seth-sievers/cc-led-driver/README.md

# cc-led-driver
A "cc" buck converter for dimming LED strips
