seth-sievers/cc-led-driver/docs/SystemDesignDocument.docx

CC LED Driver

System Design Document

Author: Seth Sievers

Created: 9/10/25

# Overview

# Table of Contents

# Hardware Design

## Requirements

- Flicker Free Dimming To Low Brightness -> DC output Buck
- Minimal emitted EMI -> Buck
- Potentiometer for Brightness Adjust with Gamma Correction

## Brightness Potentiometer (Gamma Correction)

The luminance (light energy) of an LED is roughly linear with the current through the LED. However, humans perceive luminance in a very nonlinear way, making the perceived brightness very nonlinear with output luminance. This is not ideal for manual adjustment as it is very difficult to get the brightness “just right”.

Perceived brightness roughly follows the following relation.

B=L^(1/γ) L=B^γ where γ≈2.2∈[1.5, 3]

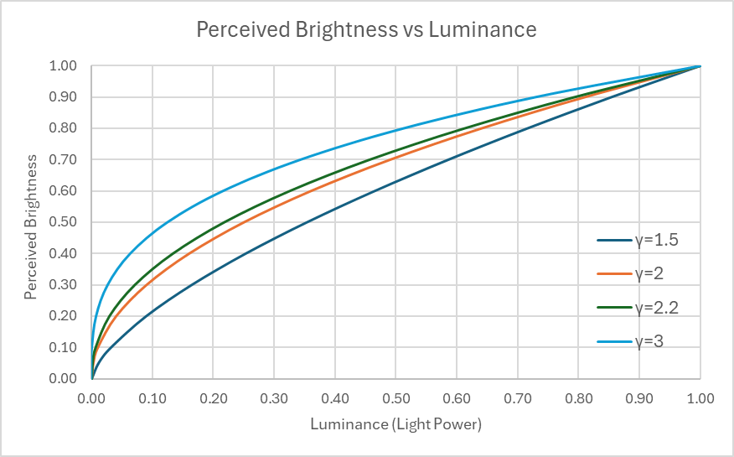
[picture p1: figure]

This is trivial to correct for in a microcontroller but since the LED driver will not have one a circuit that roughly follows the inverse of the above curve is needed. Flipping the X and Y axis to visualize the desired function:

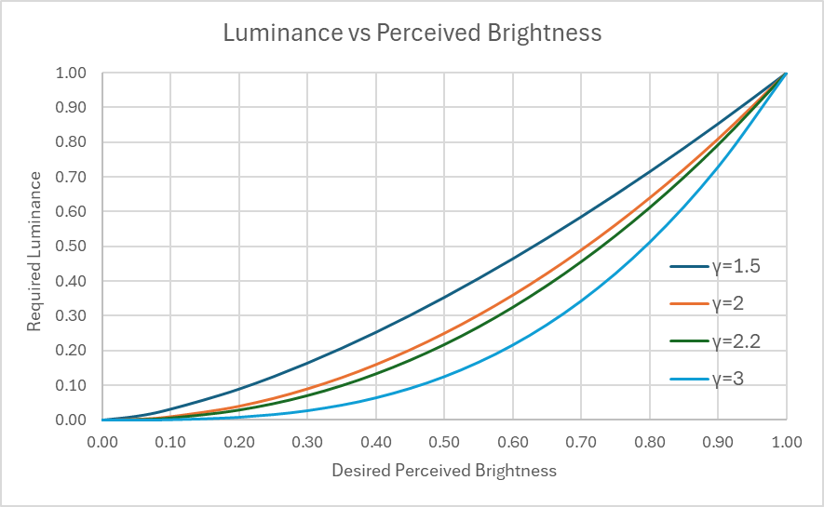
[picture p2: figure]

A rough mapping from a linear potentiometer to a curve fitting between the above family of curves would be ideal.

View Rough Circuit Sketch for a preliminary system overview.

After spending a very long time in LTspice, the following circuit was created.

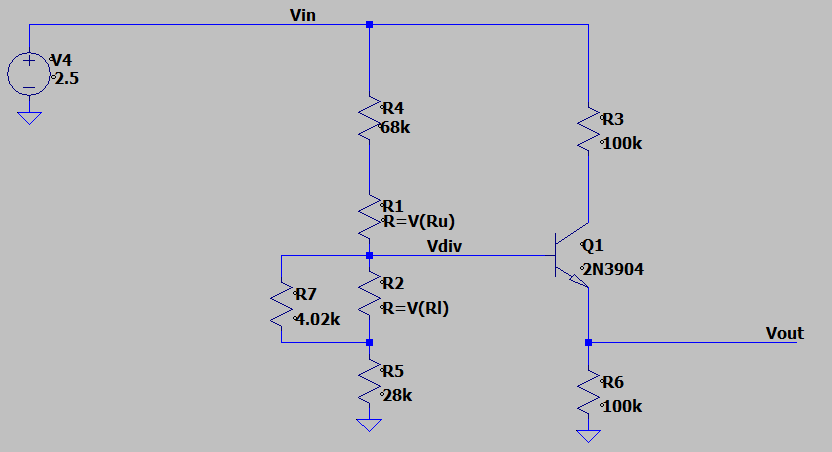
[picture p3: figure]

Which has the following response:

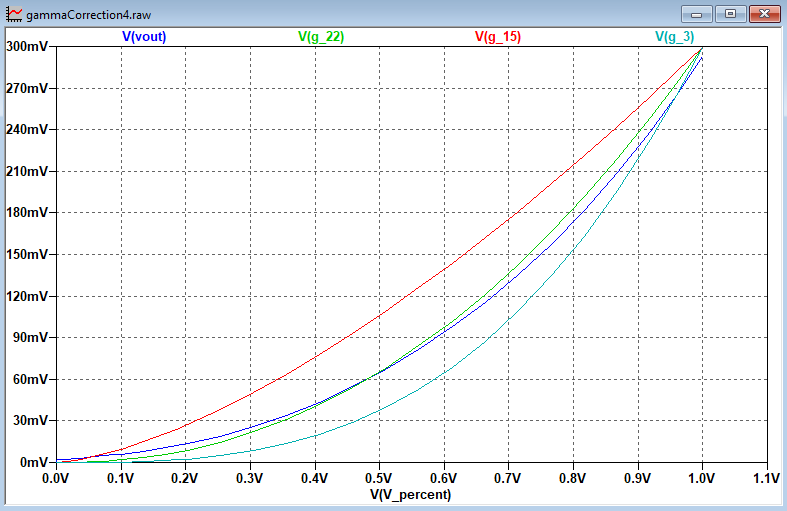
[picture p4: figure]

The above graph shows that the output almost perfectly follows the γ=2.2 curve and is well within the other boundary curves.

Next a simulation at 10C, 20C, and 30C was run to show how changes in the BJT’s VBE would impact the input output mapping.

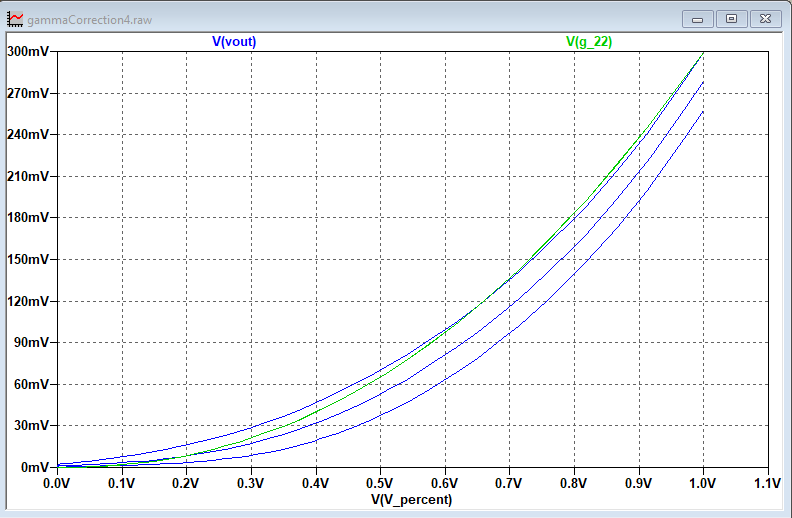
[picture p5: figure]

Luckily all curves stay mostly parallel with each other and the primary impact is small vertical offset of the mapping. This means variations in temperature will not change the relative impact in output brightness variation from turning the potentiometer but rather the overall max brightness. This BJT will be placed as far away as reasonably possible from the primary heat generating components and so large variations in temperature are not expected.

Checking the above graph shows that the minimum input percentage (V_percent) for which the resulting output voltage is above 12mV is 16%. The is the lowest setting of the potentiometer for which the led driver will turn on. Sixteen percent is adequate to ensure that noise does not cause the dimmer to flicker on and off. The highest percentage for which the output voltage is above 12mV is 34% A 16% delta for turning on the LEDs is not ideal but that is over a 20°C range which should not be encountered during a single usage. If this variance is an issue the curve or enable threshold can be adjusted.

## Buck Converter

The LED strip this dimmer is intended to power has a 12V @ 3A rating. This driver is intended to run from ~24V DC and act as a constant current source. The LMR33640 (https://www.digikey.com/en/products/detail/texas-instruments/LMR33640ADDAR/11308782) is a synchronous buck converter with a max input voltage of 36V and was chosen to the supply. It does not have a constant current mode so this will need to be implemented externally.

Using the current ripple equation from the datasheet to solve for the inductance required to achieve 30% ripple current with the maximum specified 4A output:

Yields an inductance of ~12.5µH. Solving for the minimum inductance required to avoid subharmonic oscillation:

Yields L ≥5.3μH as the lower bound.

Since lowering Vin reduces the inductance required for a % of ripple current and it is more likely that the driver will be used at input voltages lower than 24V rather than higher, the nearest lower standard inductor value of 10µH was chosen as a best guess.

The supply parameters were input into the SMPS spreadsheet to estimate inductor currents. The switching frequency is 400kHz. The efficiency was chosen to be a conservative 90% worst case.

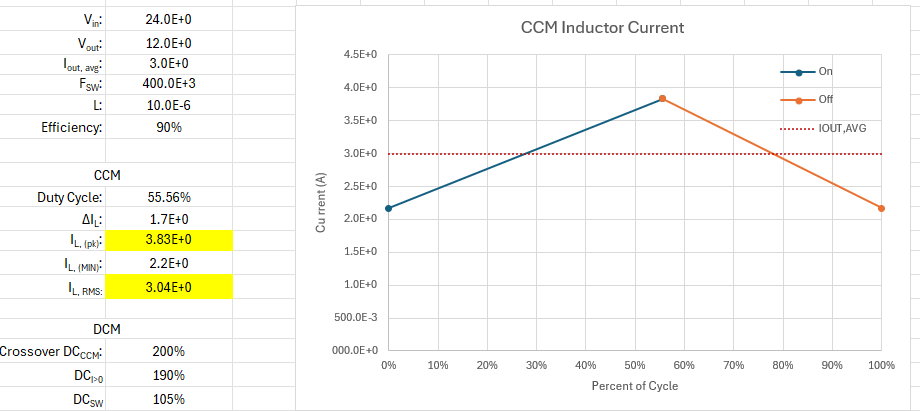
[picture p6: figure]

The spreadsheet predicts a peak inductor current of ~4A and an RMS inductor current of ~3A when providing 3A at 12V. From the converter datasheet, the high side switch current limit is typically 5.5A and the low side switch current limit is typically 4.5A so this is within the capability of the supply.

For an inductor, Vishay’s IHLP4040 (https://www.digikey.com/en/products/detail/vishay-dale/IHLP4040DZER100M11/1220709) series was chosen because it is relatively inexpensive, very capable, and has a preexisting footprint in KiCad (Inductor footprints are the worst).

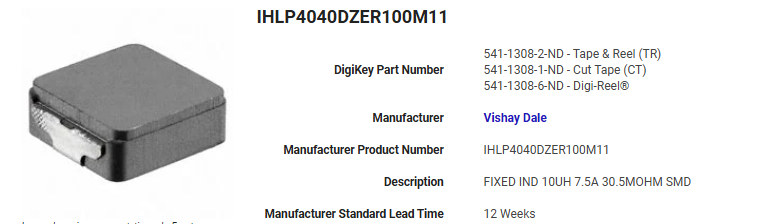
[picture p7: figure]

Specifications:

- IRMS = 7.5A
- ISAT = 7.1A
- DCR = 28mΩ

Since the IRMS and ISAT specifications for this inductor are both greater than the current limits for the switcher’s internal FETs, saturation for this inductor should be (almost) impossible, hopefully making this a very reliable supply. Furthermore, 28mΩ is a very low DC resistance and will only contribute to ~0.2% efficiency loss when the supply is providing 36W. Although AC losses will likely be higher than a ferrite core.

The current supply is as follows:

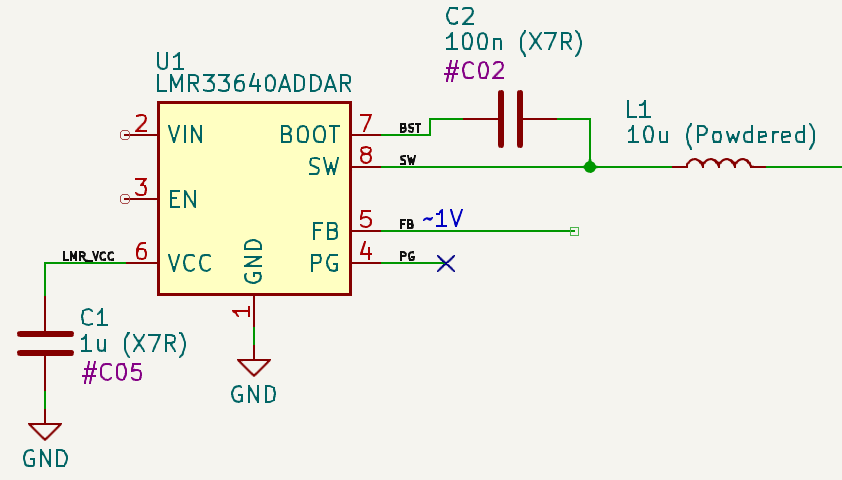
[picture p8: figure]

### Output Capacitance

Solving the output capacitance equation from the datasheet. Assume 30% inductor current ripple for a ballpark minimum. Set the voltage ripple to 100mV, Iout to 3A, and D to 56%. For worst case solve for a ∆IOUT of 3A.

Solving results in C_(OUT) ≥146µF , this is a somewhat extreme requirement as in normal steady state operation the change in current will be near zero as an LED strip does not exhibit high frequency switching.

Resolving the equation for ∆IOUT of 0.5A gives C_(OUT) ≥24µF

The datasheet also gives this table of typical values. Minimum Cout is listed as ~66 µF

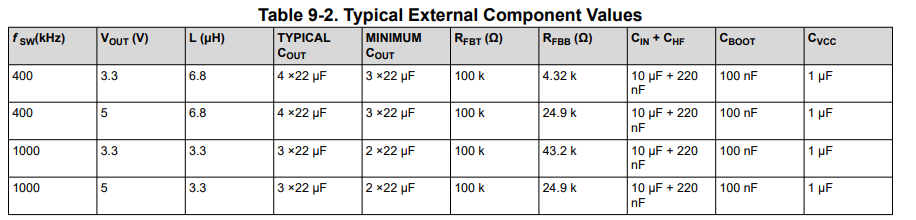
[picture p9: figure]

The datasheet does not give a formula for minimum COUT and the design example calculates 80µF. For this application, it was decided to use ten 10µF 50V X7R capacitors in a 1210 package. These capacitors have an effective capacitance of 7.1µF / ea when 13V is applied to them. The ten capacitor bank will have around 71µF of capacitance, more than the minimum specified 66 µF.

### Input Capacitance and EMI Filter

Luckily the input capacitance requirements are much less stringent. The datasheet calls for a minimum of 10 µF along with a small case size 220nF for HF bypassing. To achieve the 10µF the same 50V X7R caps as the output can be used. For the 220n cap several 100n 0603 50V caps can be used. However, I do not like putting different values of ceramic caps in parallel as it can cause resonance peaking from the high Q circuit that is formed. An LTspice sim of the input is necessary to determine if this is okay or if a damping resistance is necessary

For a buck converter, the input of the supply is also noisy since it is directly connected to a switching FET and does not have a filtering inductor like the output. Because a this a ferrite bead will be placed on the incoming ~24V supply to prevent noise conducting out and then radiating to the surrounding equipment.

The following input EMI filter was designed:

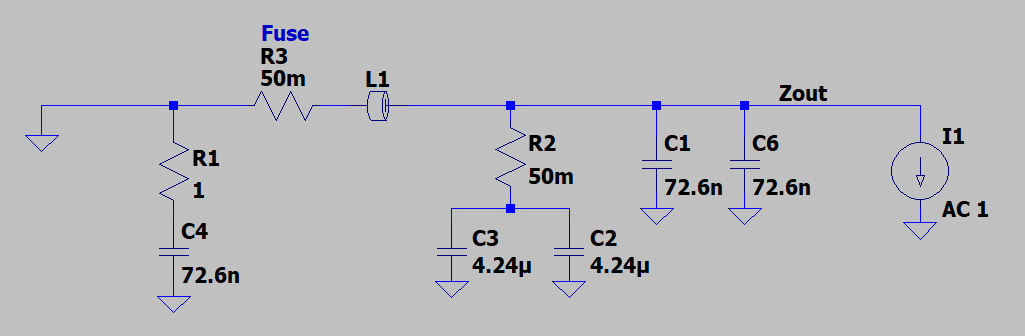
[picture p10: figure]

Resistances were strategically placed and chosen with the help of LTspice to damp out any resonances between the high Q ceramic capacitors. Since a fuse was desired, it was placed in the filter so that its resistance which would typically be undesirable is used to help damp the LC network.

The output impedance seen by the buck is as follows:

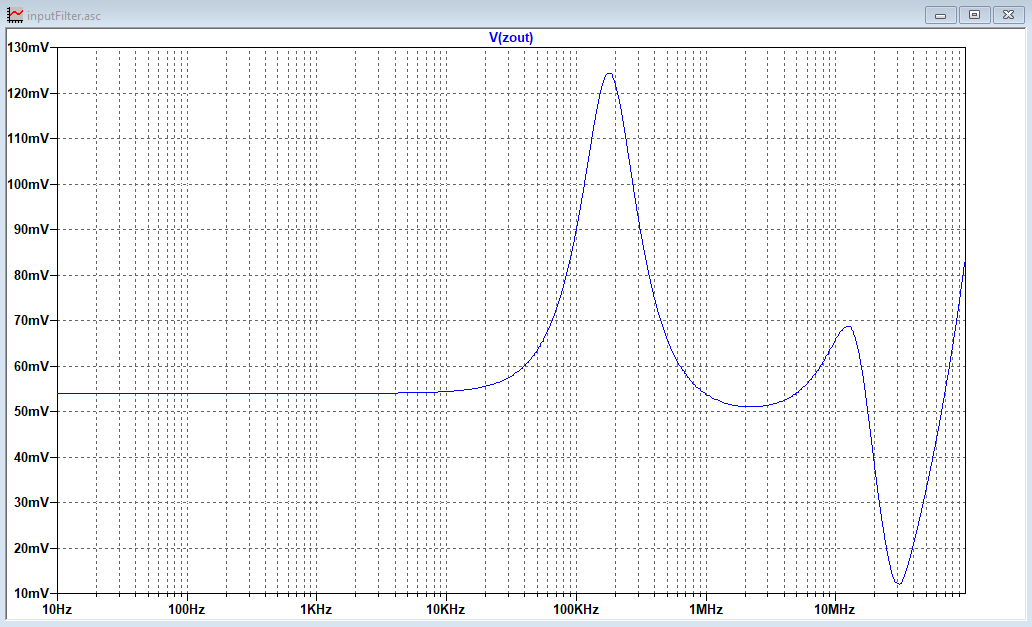
[picture p11: figure]

The Y axis of the above graph is Ohms. Note the large spike at ~175 kHz is not ideal. However, since that spike is only ~0.125Ω and since it can easily be adjusted by changing the damping resistor it will be left and tested. If the buck is still stable, this filter will provide superior damping.

The input impedance seen by the power supply source is as follows:

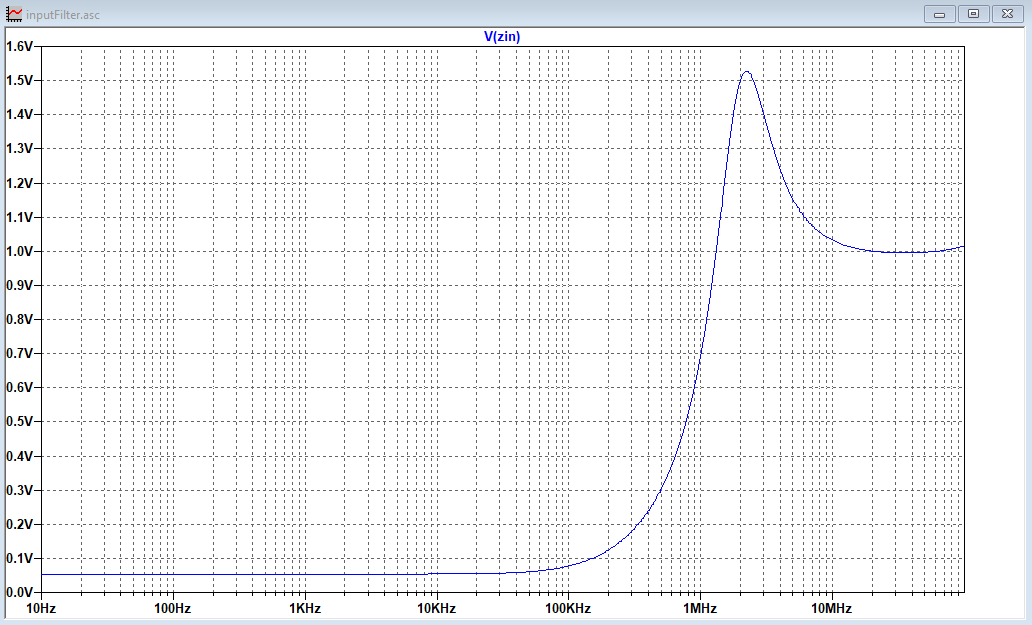
[picture p12: figure]

The above input impedance shows that the ferrite bead in combination with the ceramic capacitors cause a huge spike in input impedance that will attenuate high frequency current pulses from the supply.

And the overall frequency response from input -> output of the filter:

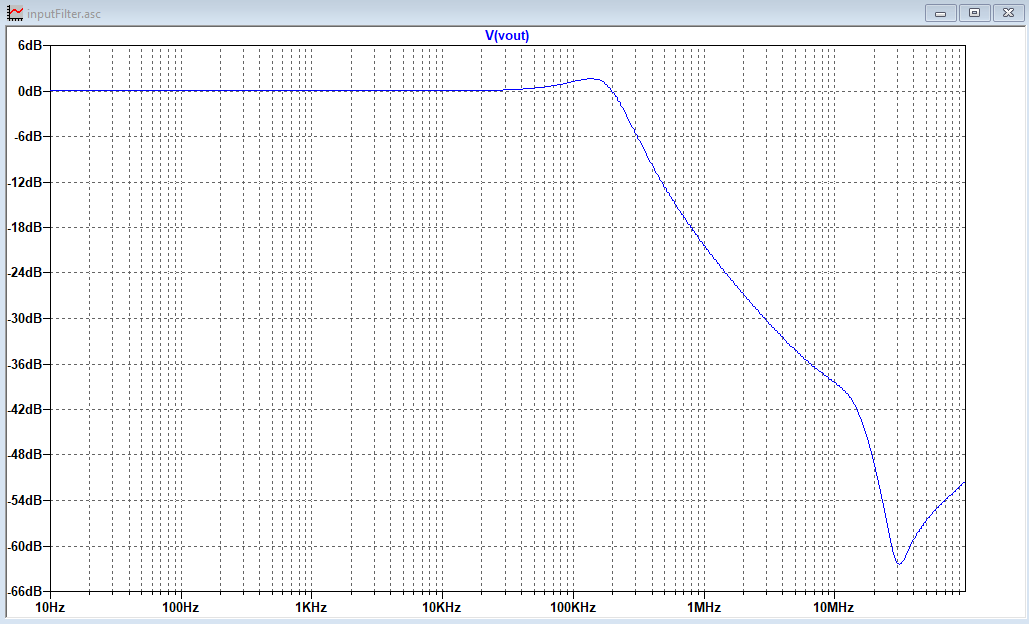
[picture p13: figure]

### CC Servo

Since the buck converter does not have a constant current mode, constant current operation will need to be implemented externally by driving the FB pin of the buck. This constant current control loop will have implications for the current set potentiometer, gamma correction circuit, and the buck feedback components. To make this solvable all these functional components must be chosen together. Start with an idea and try some values to see if it’s feasible.

One solution to regulate the buck output current is to simply use an opamp to drive the feedback pin of the buck until the current setpoint is achieved. However, since this buck has its compensation network fixed internally, this will likely prove difficult to stabilize since placing the current control loop inside the buck converters feedback will cause an additional phase shift. It is also desirable to have both a constant current control loop and a voltage control loop so that minimum and maximum output voltages can be set.

Solution:
Instead of driving the buck feedback pin directly, use the buck feedback resistor network to provide high frequency immediate feedback to the buck. The output voltage of the buck (which will directly influence the load current) will be set by a MUCH slower current feedback loop. This constant current “servo” will slowly steer or adjust the output voltage until the current drawn by the load is equal to the setpoint. Since an LED is not an active load with fast current transients this will achieve the desired constant current and correct for any temperature drift. Since the bandwidth of the current control loop will be extremely limited, it will have a minimal impact on the buck stability.

#### Rough Circuit Sketch:

#### Finalized Control Loop

The below finalized schematic snippet shows the slower current servo feedback loop. If VSET is greater than VSENSE, then the inverting integrator will slowly start increasing VCTRL. An increase in VCTRL will result in Q2 pulling the buck feedback voltage down. The much faster responding buck voltage control loop will then increase Vout which will result in a corresponding increase in LED current and thus an increase in VSENSE. VCTRL will continue to rise until VSENSE equals VSET at which point the integrator will maintain VCTRL and keep ‘steering’ the LED current back to the setpoint if it deviates.

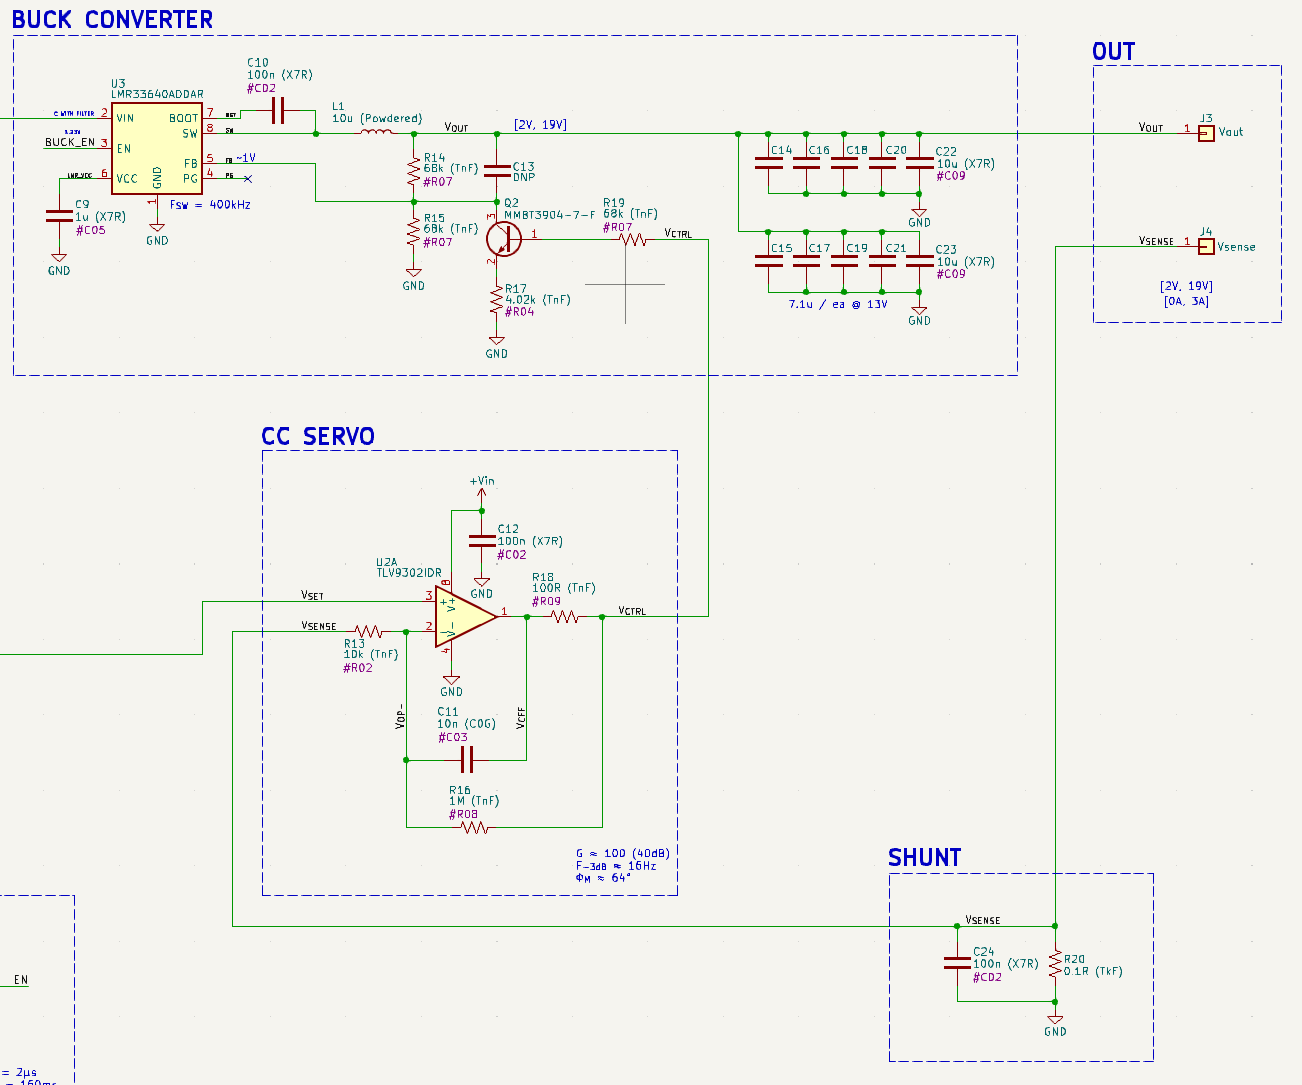
[picture p14: figure]
