seth-sievers/cc-led-driver/ltspice/Draft2.asc

C1: cap; 22.32µ; Rser=3m Lser=1.2n
C2: cap; 919n; Rser=10.9m Lser=372p
C3: cap; 919n; Rser=10.9m Lser=372p
C4: cap; 919n; Rser=10.9m Lser=372p
C5: cap; 919n; Rser=10.9m Lser=372p
C6: cap; 919n; Rser=10.9m Lser=372p
C7: cap; 919n; Rser=10.9m Lser=372p
C8: cap; 22.32µ; Rser=3m Lser=1.2n
I1: current; AC 1
L1: ind; 20n
L2: ind; 10n
R1: res; {Rdamp}
R2: res; 20m
R3: res; {Rdamp}
Named nets: 0, Z
.ac dec 1000 10 1G
.step param Rdamp list 1u 10m 20m 30m 40m 50m 100m 200m 1
