seth-sievers/cc-led-driver/ltspice/Draft3.asc

C1: cap; 20n
L1: ind; 100m
V1: voltage; PULSE(0 2.5 0 1n 1n 140.4u 280.99u)
Named nets: 0
.tran 0 1m 0 1u
