seth-sievers/cc-led-driver/ltspice/Draft1.asc

C1: cap; 94.55n; Rser=25.1m Lser=381p
C2: cap; 9.85µ; Rser=3m Lser=1.2n
I1: current; AC 1
R1: res; 100m
Named nets: 0, Z
.ac dec 1000 10 100Meg
