seth-sievers/cc-led-driver/ltspice/inputFilter.asc

C1: cap; 72.6n; Rser=25.1m Lser=381.7p
C2: cap; 4.24µ; Rser=2.9m Lser=1.1n
C3: cap; 4.24µ; Rser=2.9m Lser=1.1n
C4: cap; 72.6n; Rser=25.1m Lser=381.7p
C6: cap; 72.6n; Rser=25.1m Lser=381.7p
L1: FerriteBead; 88.4n; Rser=4m Rpar=37 Cpar=1.2p
R1: res; 1
R2: res; 50m
R3: res; 50m
V1: voltage; AC 1
Named nets: 0, Zin, Vout
.ac dec 1000 10 100Meg
Fuse
