seth-sievers/cc-led-driver/ltspice/buck_en.asc

C1: cap; 100n
D1: diode; 1N4148
D2: diode; 1N4148
R1: res; 200k
V1: voltage; PULSE(0 24 1m 1n 1n 100m 20); Rser=10
Named nets: 0, EN, BUCK_EN
.tran 0 0.3 0 1u
