seth-sievers/cc-led-driver/ltspice/cc_servo.asc

C1: cap; 10n
C2: cap; 100n
C3: cap; 20µ
D1: zener; UFZV9_1B
D2: zener; UFZV9_1B
D3: zener; UFZV9_1B
Q1: npn; 2N3904
R1: res; 100
R2: res; 200k
R3: res; 1k
R5: res; 0.1
R6: res; 850m
R7: res; 68k
R8: res; 68k
R9: res; 10m
R10: res; 4.02k
R11: res; 68k
U1: opamp2; TLV9302
U2: opamp
V1: voltage; 24
V2: voltage; 1; Rser=1
V3: voltage; 0
V4: voltage; PULSE(0 200m 100m 100m 100m 10 20)
Named nets: +24V, 0, -10V, Vctrl, Vsense, Vset, Vout, Vfb, Vb
.inc tlv9302.lib
.tran 0 1 0 100u
BUCK APPROXIMATION
"LED STRIP"
.lib opamp.sub
SHUNT
CC Servo
BW: ~10k
