seth-sievers/cc-led-driver/ltspice/en2.asc

B1: bv; V={Rpot}*(1-V(V_percent))
B2: bv; V={Rpot}*(V(V_percent))
B3: bv; V=pow({V(V_percent)}, 2.2)*{V(Vmax)}
B4: bv; V=pow({V(V_percent)}, 1.5)*{V(Vmax)}
B5: bv; V=pow({V(V_percent)}, 3)*{V(Vmax)}
C1: cap; 100n
C2: cap; 10n
C3: cap; 1n
C4: cap; 100n
C5: cap; 100n
C6: cap; 20µ
C7: cap; 120n
D1: diode; BAV199HY
D2: diode; BAV199HY
D3: zener; UFZV9_1B
D4: zener; UFZV9_1B
D5: zener; UFZV9_1B
Q1: npn; 2N3904
Q2: npn; 2N3904
R1: res; R=V(Ru)
R2: res; R=V(Rl)
R3: res; 100k
R4: res; 68k
R5: res; 28k
R6: res; 100k
R7: res; 4.02k
R8: res; 20k
R9: res; 100
R10: res; 1Meg
R11: res; 10k
R12: res; 200k
R13: res; 1k
R14: res; 200k
R15: res; 0.1
R16: res; 850m
R17: res; 68k
R18: res; 68k
R19: res; 10m
R20: res; 4.02k
R21: res; 68k
R22: res; 10k
R23: res; 1k
S1: sw; ENSW
S2: sw; ENSW_N
S3: sw; ENSW
U1: LM4040_NA2P5
U2: opamp2; TLV9302
U3: opamp2; TLV9302
U4: opamp
V1: voltage; PULSE(0 999m 10m 250m 250m 10 20)
V2: voltage; 300m
V3: voltage; 1n
V4: voltage; 1; Rser=1
V5: voltage; PULSE(0 24 1m 40n 40n 10 20); Rser=1m
V6: voltage; PULSE(2 0 11m 40n 40n 10 20)
Named nets: 0, V_percent, Ru, Rl, g_22, g_15, g_3, Vmax, Vset, Vdiv, Vin, VREF_2V5, Vctrl, VREF_12mV, EN, BUCK_EN, Vsense, Vout, Vfb, Vb, SS
.param Rpot=100k
.tran 0 1 0 100u
.inc LM4040_NA2P5_TRANS.lib
VREF
BRIGHTNESS CONTROL
.inc tlv9302.lib
.lib opamp.sub
CC Servo
SHUNT
BUCK APPROXIMATION
"LED STRIP"
BW: ~10k
.Model ENSW SW(Ron=1m Roff=1G Vt=1.231 Vh=1m)
.Model ENSW_N SW(Ron=1G Roff=1m Vt=1.231 Vh=1m)
