seth-sievers/cc-led-driver/ltspice/inverting_integrator_amp.asc

C1: cap; 10n
R1: res; 100
R2: res; 1Meg
R3: res; 10k
R4: res; 1k
U1: opamp2; TLV9302
V1: voltage; 24
V2: voltage; 0.15
V3: voltage; -10
V5: voltage; PULSE(0 0.3 1m 1n 1n 100m 200m)
Named nets: +24V, 0, -10V, Vout, Vin, Vset
.inc tlv9302.lib
.tran 0 1 0 100u
