seth-sievers/cc-led-driver/ltspice/inverting_integrator_amp_f_resp.asc

C1: cap; 10n
R1: res; 100
R2: res; 1Meg
R3: res; 10k
R4: res; 68k
U1: opamp2; TLV9302
V1: voltage; 20
V2: voltage; AC 1
V3: voltage; -20
Named nets: +24V, 0, -10V, Vout, Vin, Vset
.inc tlv9302.lib
;tran 0 1 0 100u
.ac dec 1000 1 100k
