seth-sievers/cc-led-driver/ltspice/gammaCorrection2.asc

B1: bv; V={Rpot}*(1-V(V_percent))
B2: bv; V={Rpot}*(V(V_percent))
B3: bv; V=pow({V(V_percent)}, 2.2)*{V(Vmax)}
B4: bv; V=pow({V(V_percent)}, 1.5)*{V(Vmax)}
B5: bv; V=pow({V(V_percent)}, 3)*{V(Vmax)}
Q1: npn; 2N3904
R1: res; R=V(Ru)
R2: res; R=V(Rl)
R3: res; 330k
R4: res; 330k
R5: res; 60.4k
R6: res; 330k
R7: res; 1Meg
V1: voltage; PULSE(0 1 0 1m 1m 10 20)
V2: voltage; 300m
V3: voltage; 1n
V4: voltage; 2.5
Named nets: 0, V_percent, Ru, Rl, Vin, g_22, g_15, g_3, Vmax, Vout
.param Rpot=100k
.tran 0 1m 0 100n
