seth-sievers/cc-led-driver/ltspice/gammaCorrection.asc

B1: bv; V={Rpot}*(1-V(V_percent))
B2: bv; V={Rpot}*(V(V_percent))
R1: res; R=V(Ru)
R2: res; R=V(Rl)
R3: res; 10k
V1: voltage; PULSE(0 1 0 1m 1m 10 20)
V2: voltage; 1
V3: voltage; 1n
Named nets: 0, V_percent, Ru, Rl, Vout, Vin
.param Rpot=100k
.tran 0 1m 0 100n
