seth-sievers/cc-led-driver/kicad/cc-led-driver.kicad_pcb

## KiCad design kicad/cc-led-driver.kicad_pcb (2025-10-31)

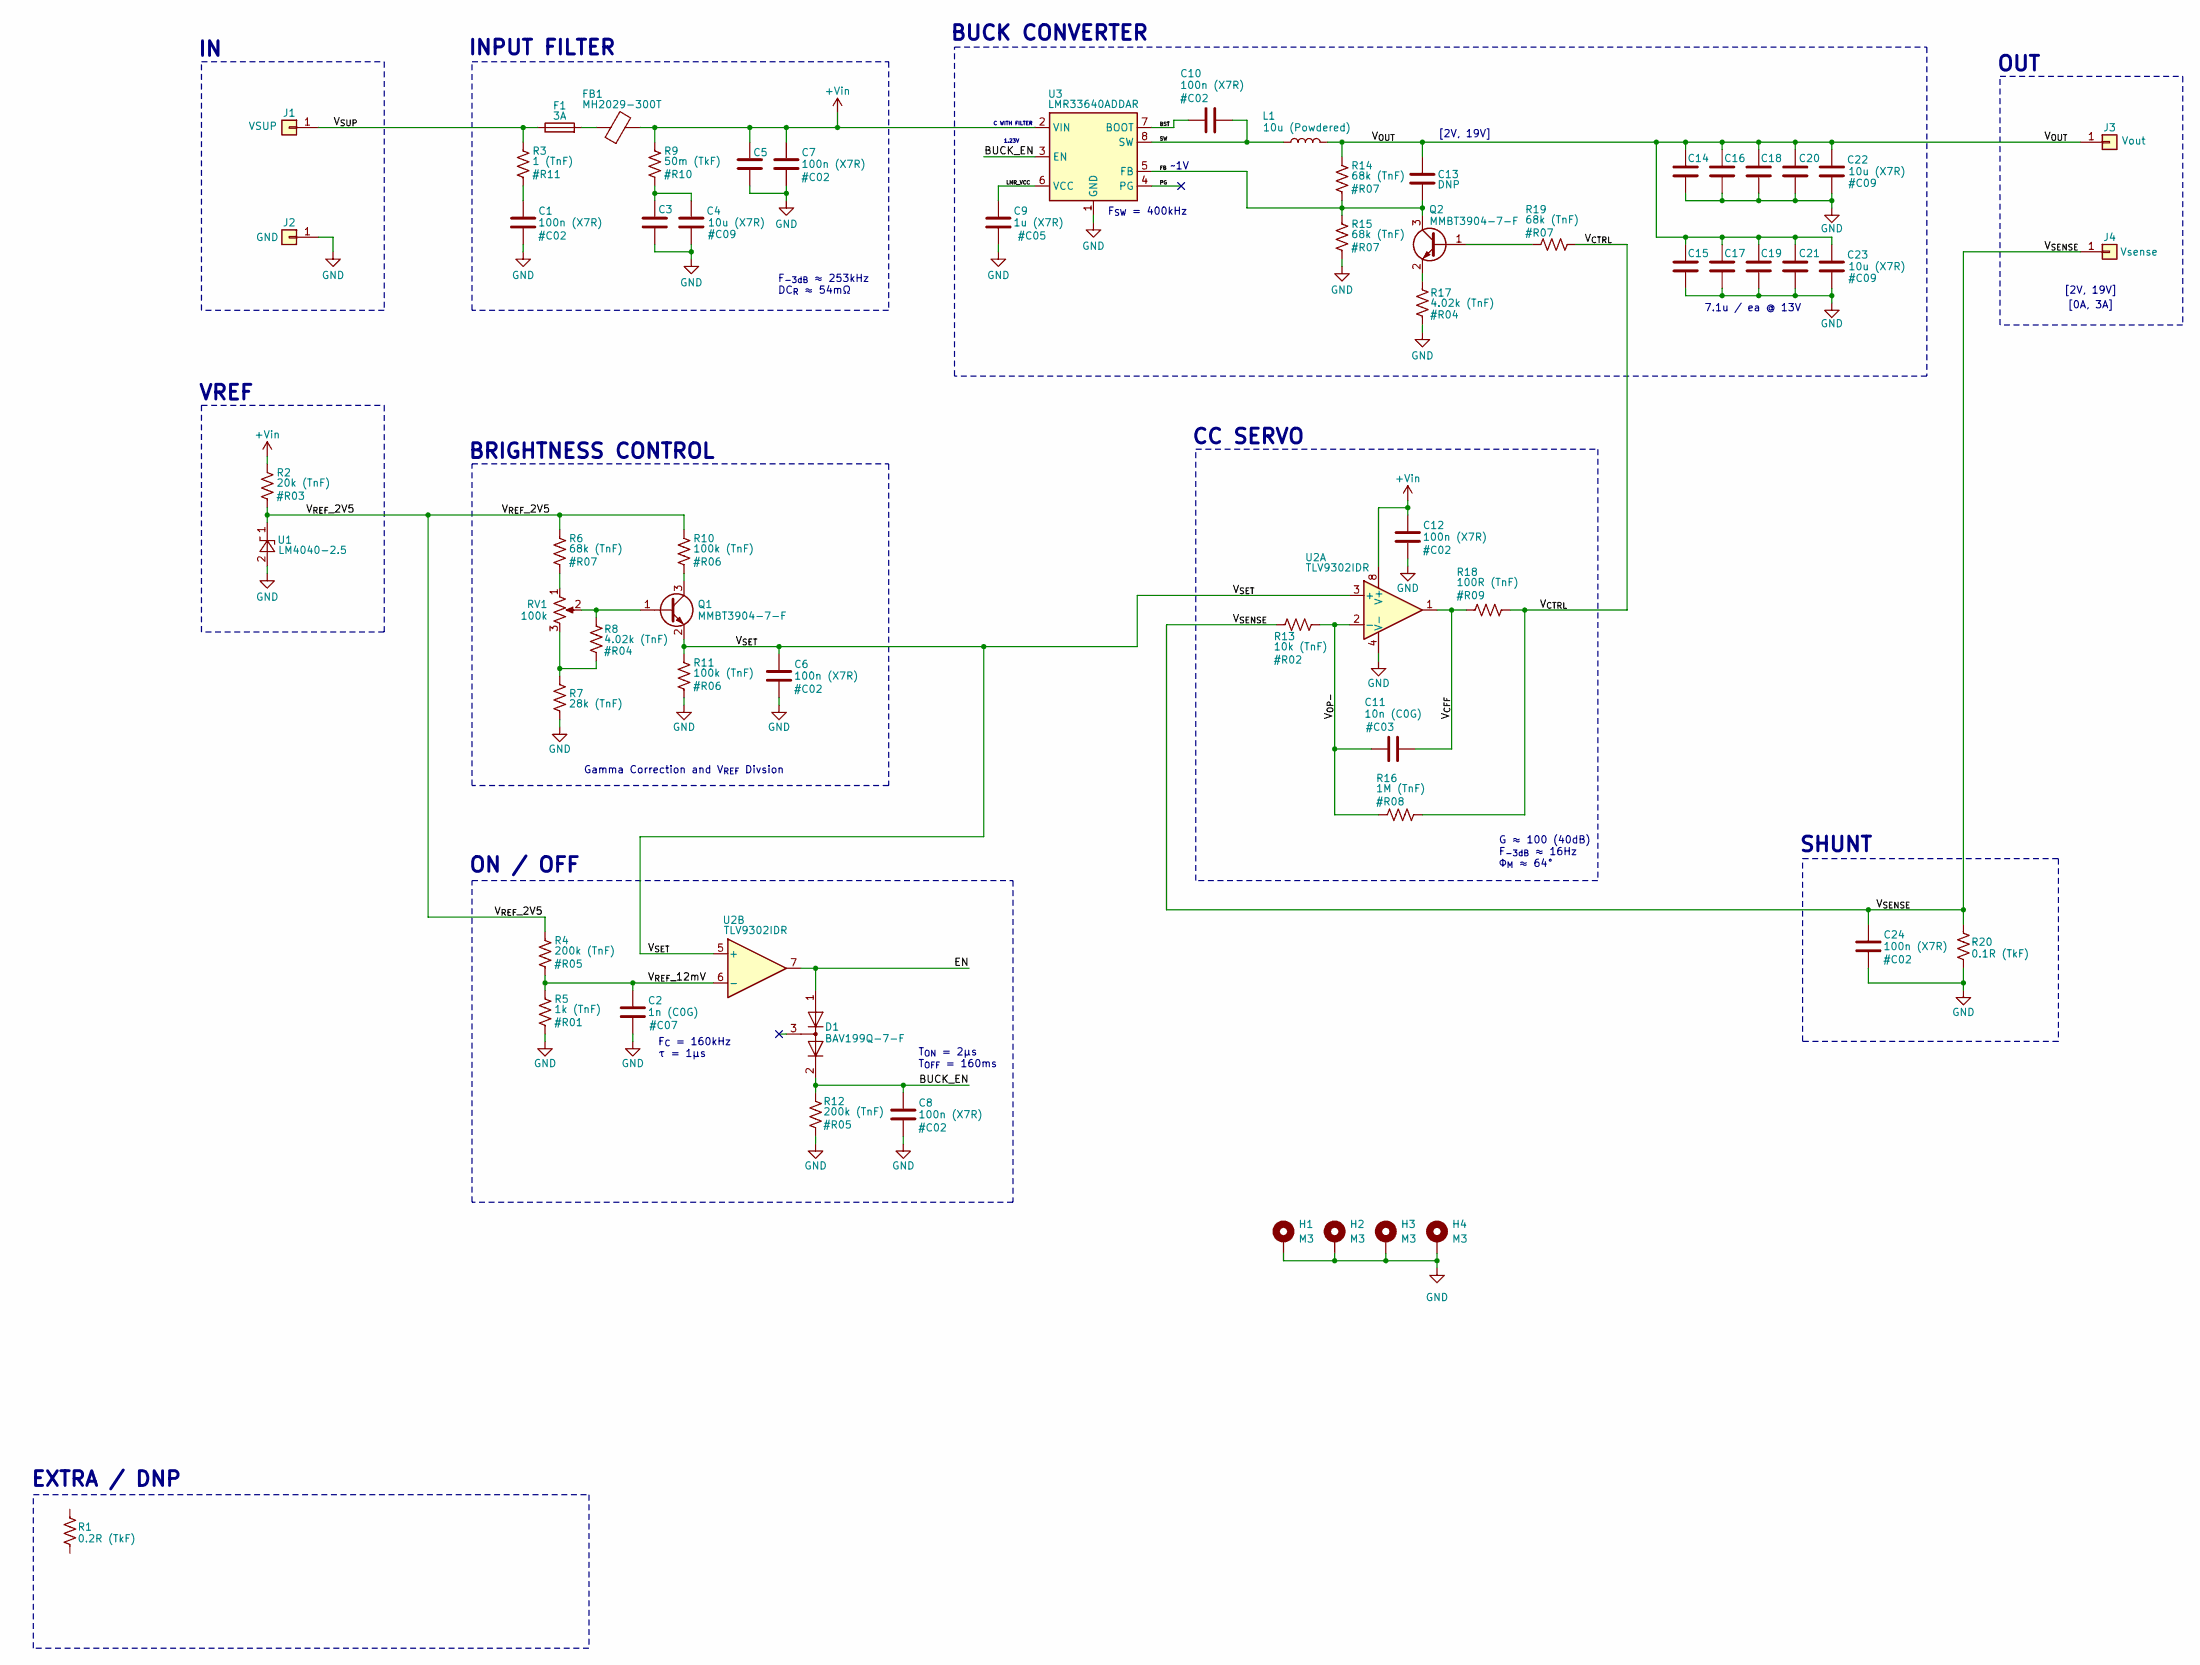
[picture p15: schematic cc-led-driver.kicad_sch, Constant Current LED Dimmer]

Parts:
C1, C5, C6, C7, C8, C10, C12, C24: 100n (X7R); C_0603_1608Metric
C2: 1n (C0G); C_0603_1608Metric
C3, C4, C14, C15, C16, C17, C18, C19, C20, C21, C22, C23: 10u (X7R); C_1210_3225Metric
C9: 1u (X7R); C_0603_1608Metric
C11: 10n (C0G); C_0603_1608Metric
C13: DNP; C_0603_1608Metric
D1: BAV199Q-7-F; SOT-23
F1: 3A; Fuse_1206_3216Metric
FB1: MH2029-300T; L_0805_2012Metric
H1, H2, H3, H4: M3; MountingHole_2.2mm_M2_DIN965_Pad
J1: VSUP; 20AWG
J2: GND; 20AWG
J3: Vout; 20AWG
J4: Vsense; 20AWG
L1: 10u (Powdered); L_Vishay_IHLP-4040
Q1, Q2: MMBT3904-7-F; SOT-23
R1: 0.2R (TkF); R_1206_3216Metric
R2: 20k (TnF); R_0603_1608Metric
R3: 1 (TnF); R_0603_1608Metric
R4, R12: 200k (TnF); R_0603_1608Metric
R5: 1k (TnF); R_0603_1608Metric
R6, R14, R15, R19: 68k (TnF); R_0603_1608Metric
R7: 28k (TnF); R_0603_1608Metric
R8, R17: 4.02k (TnF); R_0603_1608Metric
R9: 50m (TkF); R_0603_1608Metric
R10, R11: 100k (TnF); R_0603_1608Metric
R13: 10k (TnF); R_0603_1608Metric
R16: 1M (TnF); R_0603_1608Metric
R18: 100R (TnF); R_0603_1608Metric
R20: 0.1R (TkF); R_1206_3216Metric
RV1: 100k; Potentiometer_Bourns_PTV09A-1_Single_Vertical
U1: LM4040-2.5; SOT-23
U2: TLV9302IDR; SOIC-8_3.9x4.9mm_P1.27mm
U3: LMR33640ADDAR; Texas_HSOP-8-1EP_3.9x4.9mm_P1.27mm_ThermalVias

Connections:
+Vin: C5.1, C7.1, C12.1, FB1.2, R2.1, R9.1, U2.8 (V+), U3.2 (VIN)
/BST: C10.1, U3.7 (BOOT)
/BUCK_EN: C8.1, D1.2 (A), R12.1, U3.3 (EN)
/EN: D1.1 (K), U2.7
/FB: C13.2, Q2.3 (C), R14.2, R15.1, U3.5 (FB)
/LMR_VCC: C9.1, U3.6 (VCC)
/PG: U3.4 (PG)
/SW: C10.2, L1.1, U3.8 (SW)
/V_{CFF}: C11.2, R18.1, U2.1
/V_{CTRL}: R16.2, R18.2, R19.2
/V_{OP-}: C11.1, R13.2, R16.1, U2.2 (-)
/V_{OUT}: C13.1, C14.1, C15.1, C16.1, C17.1, C18.1, C19.1, C20.1, C21.1, C22.1, C23.1, J3.1, L1.2, R14.1
/V_{REF}_2V5: R2.2, R4.1, R6.1, R10.1, U1.1 (K)
/V_{REF}_12mV: C2.1, R4.2, R5.1, U2.6 (-)
/V_{SENSE}: C24.1, J4.1, R13.1, R20.1
/V_{SET}: C6.1, Q1.2 (E), R11.1, U2.3 (+), U2.5 (+)
/V_{SUP}: F1.1, J1.1, R3.1
GND: C1.2, C2.2, C3.2, C4.2, C5.2, C6.2, C7.2, C8.2, C9.2, C12.2, C14.2, C15.2, C16.2, C17.2, C18.2, C19.2, C20.2, C21.2, C22.2, C23.2, C24.2, H1.1, H2.1, H3.1, H4.1, J2.1, R5.2, R7.2, R11.2, R12.2, R15.2, R17.2, R20.2, U1.2 (A), U2.4 (V-), U3.1 (GND), U3.9 (GND)
unnamed: C1.1, R3.2
unnamed: C3.1, C4.1, R9.2
unnamed: F1.2, FB1.1
unnamed: Q1.1 (B), R8.1, RV1.2
unnamed: Q1.3 (C), R10.2
unnamed: Q2.1 (B), R19.1
unnamed: Q2.2 (E), R17.1
unnamed: R6.2, RV1.1
unnamed: R7.1, R8.2, RV1.3

Notes on the sheet:
C WITH FILTER
G ≈ 100 (40dB) F_{-3dB} ≈ 16Hz Φ_{M} ≈ 64°
BUCK CONVERTER
OUT
1.23V
INPUT FILTER
BRIGHTNESS CONTROL
EXTRA / DNP
CC SERVO
[2V, 19V]
[0A, 3A]
ON / OFF
F_{-3dB} ≈ 253kHz DC_{R} ≈ 54mΩ
T_{ON} = 2μs T_{OFF} = 160ms
SHUNT
Gamma Correction and V_{REF} Divsion
VREF
F_{C} = 160kHz τ = 1μs
~1V
F_{SW} = 400kHz
7.1u / ea @ 13V

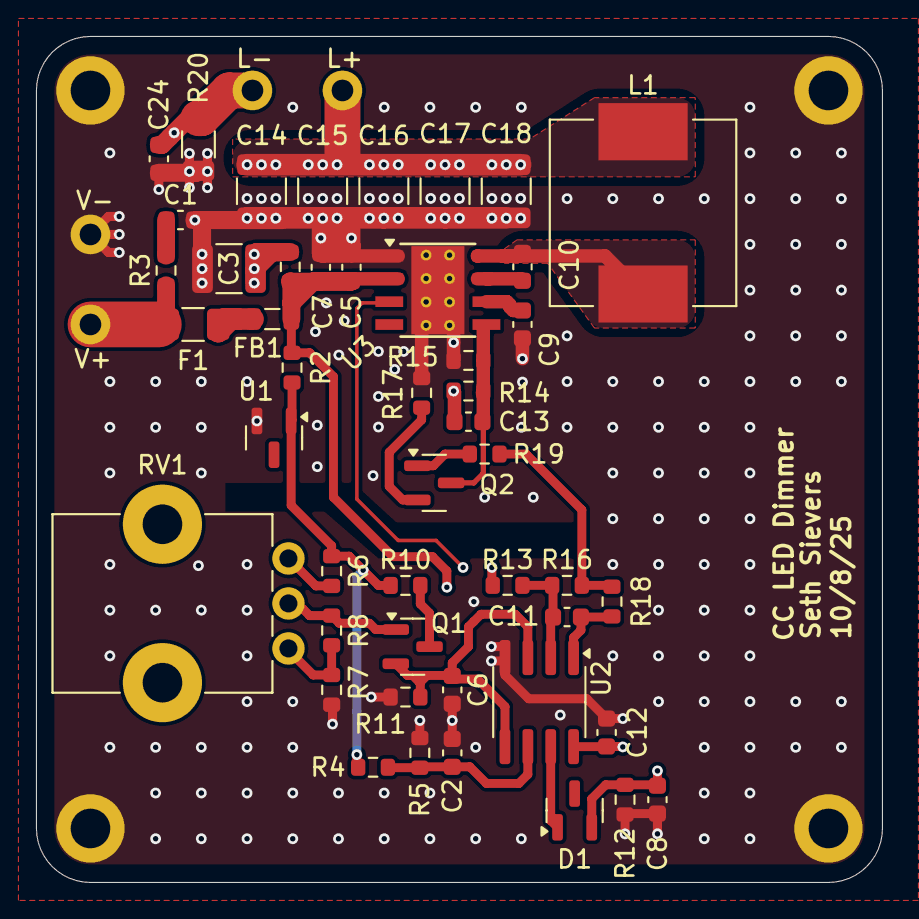
[picture p16: board cc-led-driver.kicad_pcb from above]

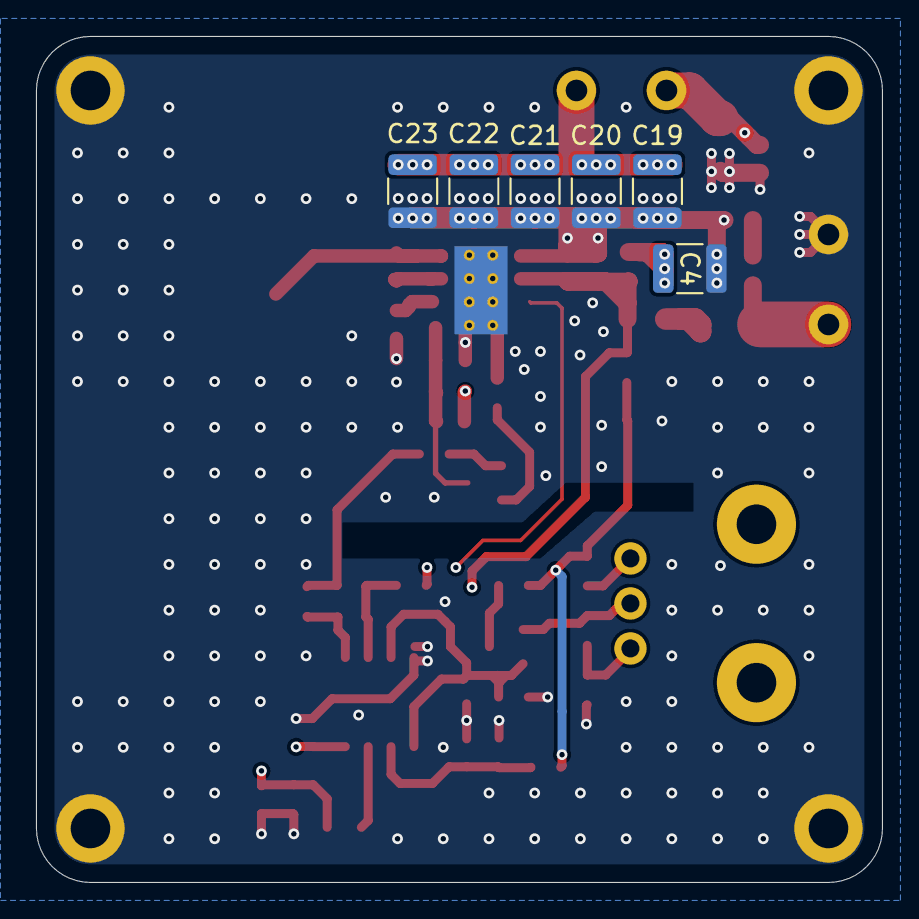
[picture p17: board cc-led-driver.kicad_pcb from below]

Board: 4 copper layers, 47.0 x 47.0 mm, 61 parts (6 on the bottom side), 26 nets.
