seth-sievers/cc-led-driver/(commit log)

2025-09-14 file sync
    [SMPS_calc.xlsx, cc-led-driver.kicad_pcb, cc-led-driver.kicad_sch, luminance_vs_brightness.xlsx]
2025-09-15 gamma correction simulated
    [cc-led-driver.kicad_sch]
2025-09-22 progress on schematic
    [cc-led-driver.kicad_sch]
2025-10-10 completed schematic and ordered gerbers
    [cc-led-driver-B_Cu.gbl, cc-led-driver-B_Mask.gbs, cc-led-driver-B_Paste.gbp, cc-led-driver-B_Silkscreen.gbo, cc-led-driver-Edge_Cuts.gm1, cc-led-driver-F_Cu.gtl, cc-led-driver-F_Mask.gts, cc-led-driver-F_Paste.gtp]
2025-10-22 exported BOM
    [SMPS_calc.xlsx, cc-led-driver.csv]
2025-10-31 update files
    [cc-led-driver.kicad_pcb, efficiency.xlsx]
